AndrewwChon/PLL_MOSbius/bond_wire/README.md

## Bond Wire

The bond wires from the die to the package were modelled based on Jingde Hu's write-up for the QFN package.
This write-up takes inspiration from slides provided in Professor Peter Kinget's VLSI design course.
