AndrewwChon/PLL_MOSbius/bond_wire/MOSbius_Track1_Bonding_Diagram_Draft_04062026.pdf

### Chipathon 2025 MOSbius Track 1 Bonding Diagram Dra (NE/SW)

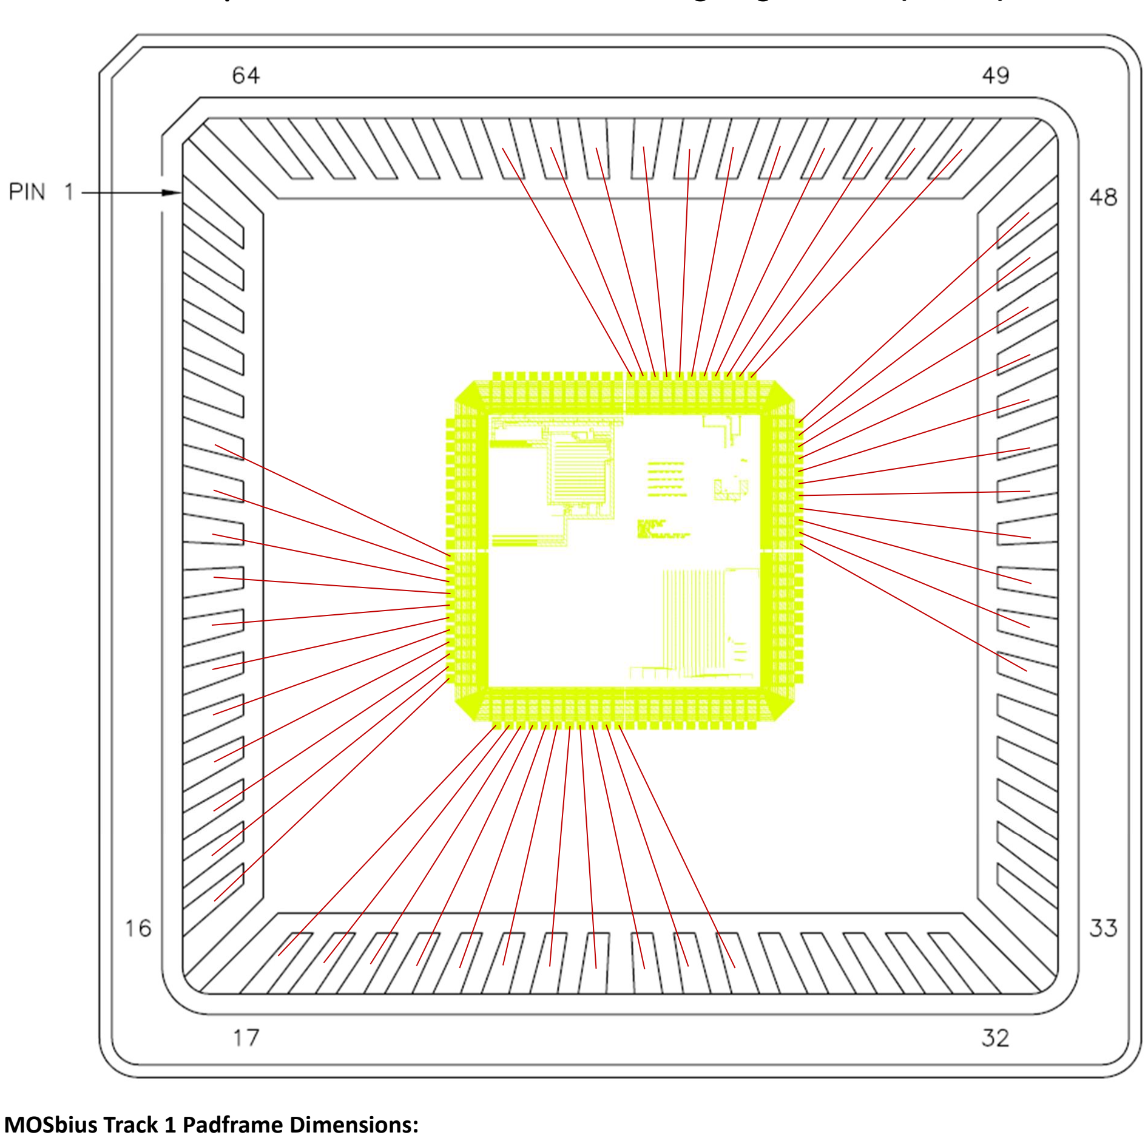
[picture p15: figure]
MOSbius Track 1 Padframe Dimensions:

o Overall Padframe Dimensions: 2.935 mm x 2.935 mm o Individual Pad Dimensions: 65.325 um x 68 um
o Pad/Passivaon Opening: 60 um x 60 um o Pad Pitch: 100 um
Package Dimensions (LQFP10X10-64-OP-01):
o Overall Package Dimensions: 10 mm x 10 mm
o Die Pad Dimensions: 6.858 mm x 6.858 mm Addional Informaon:
o Qty Packaged: 25
o Esmated Max Wire Length: 2 mm
o Lid Type: TBD. Please use Alumina Ceramic for budget esmates

### Chipathon 2025 MOSbius Track 1 Bonding Diagram Dra (NW/SE)

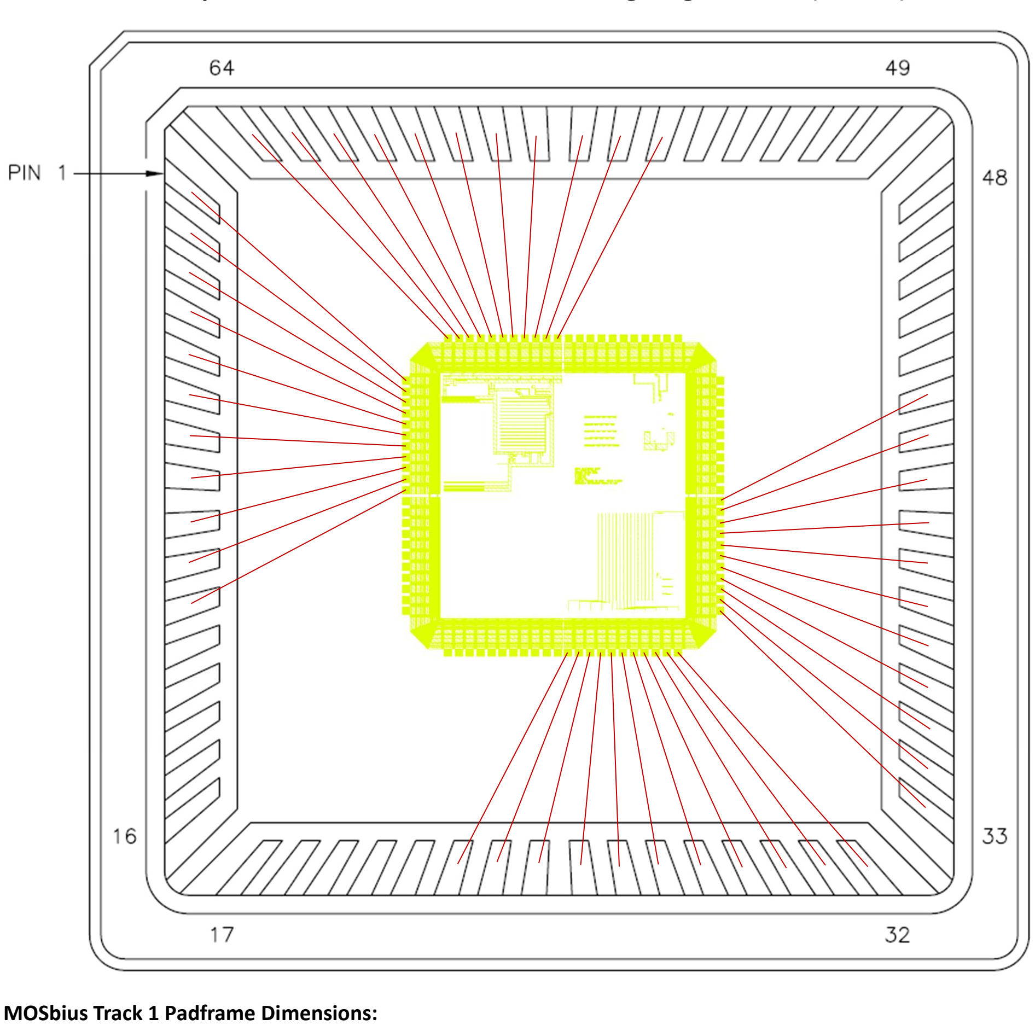
[picture p16: figure]
MOSbius Track 1 Padframe Dimensions:

o Overall Padframe Dimensions: 2.935 mm x 2.935 mm o Individual Pad Dimensions: 65.325 um x 68 um
o Pad/Passivaon Opening: 60 um x 60 um o Pad Pitch: 100 um
Package Dimensions (LQFP10X10-64-OP-01):
o Overall Package Dimensions: 10 mm x 10 mm
o Die Pad Dimensions: 6.858 mm x 6.858 mm Addional Informaon:
o Qty Packaged: 25
o Esmated Max Wire Length: 2 mm
o Lid Type: TBD. Please use Alumina Ceramic for budget esmates
