AndrewwChon/PLL_MOSbius/bond_wire/bond_wire_img.png

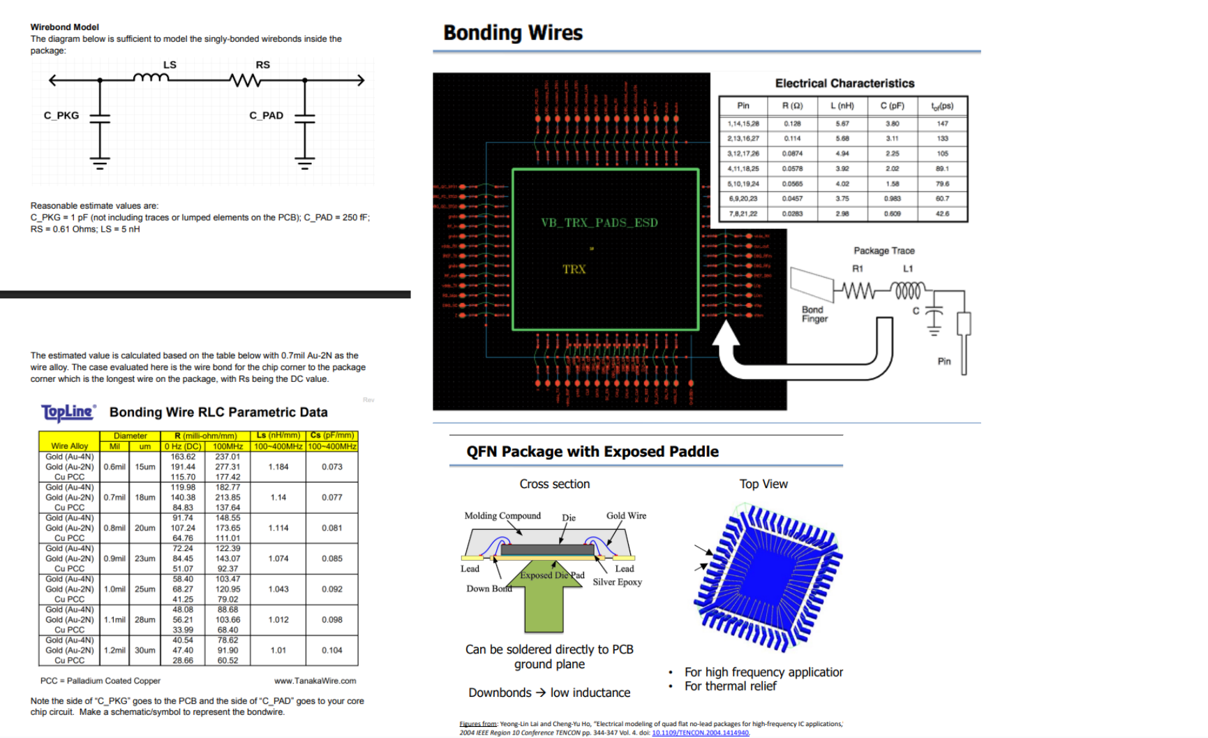
bond_wire/bond_wire_img.png
