AndrewwChon/PLL_MOSbius/docs/screenshots/add_collaborators.png

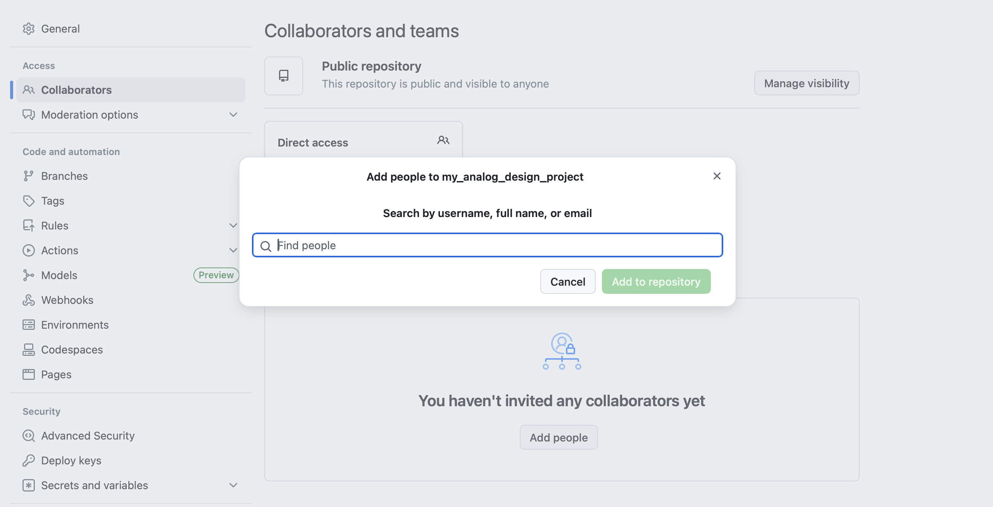
docs/screenshots/add_collaborators.png
