AndrewwChon/PLL_MOSbius/docs/screenshots/clone_your_repo.png

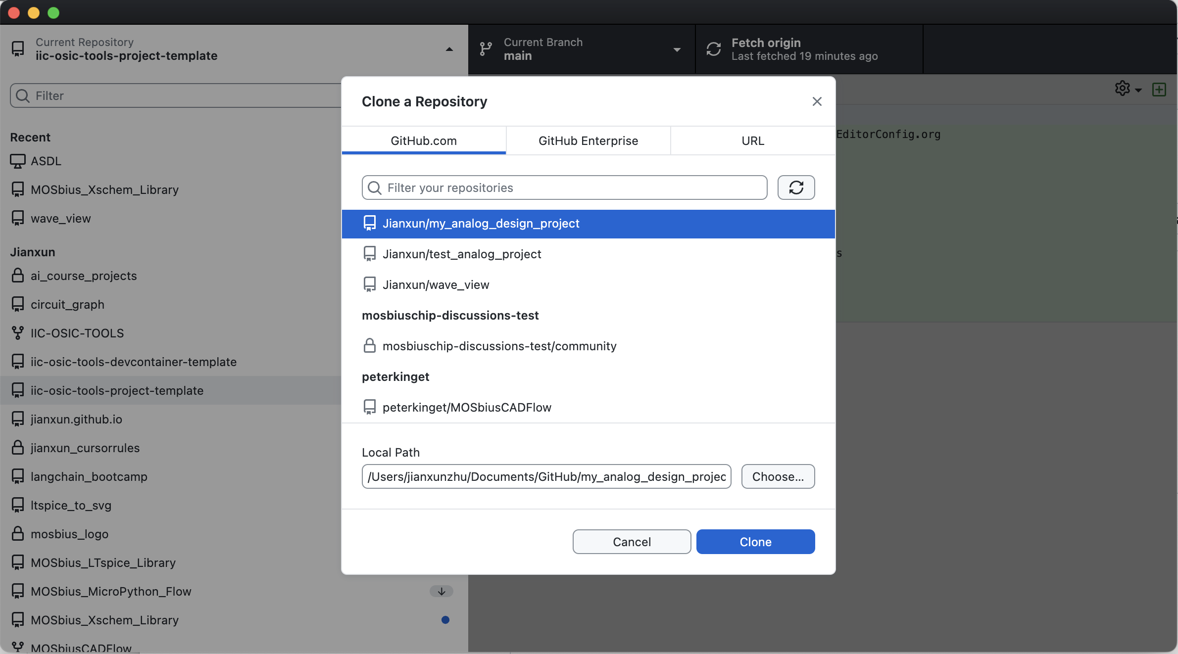
docs/screenshots/clone_your_repo.png
