AndrewwChon/PLL_MOSbius/docs/screenshots/create_new_repo.png

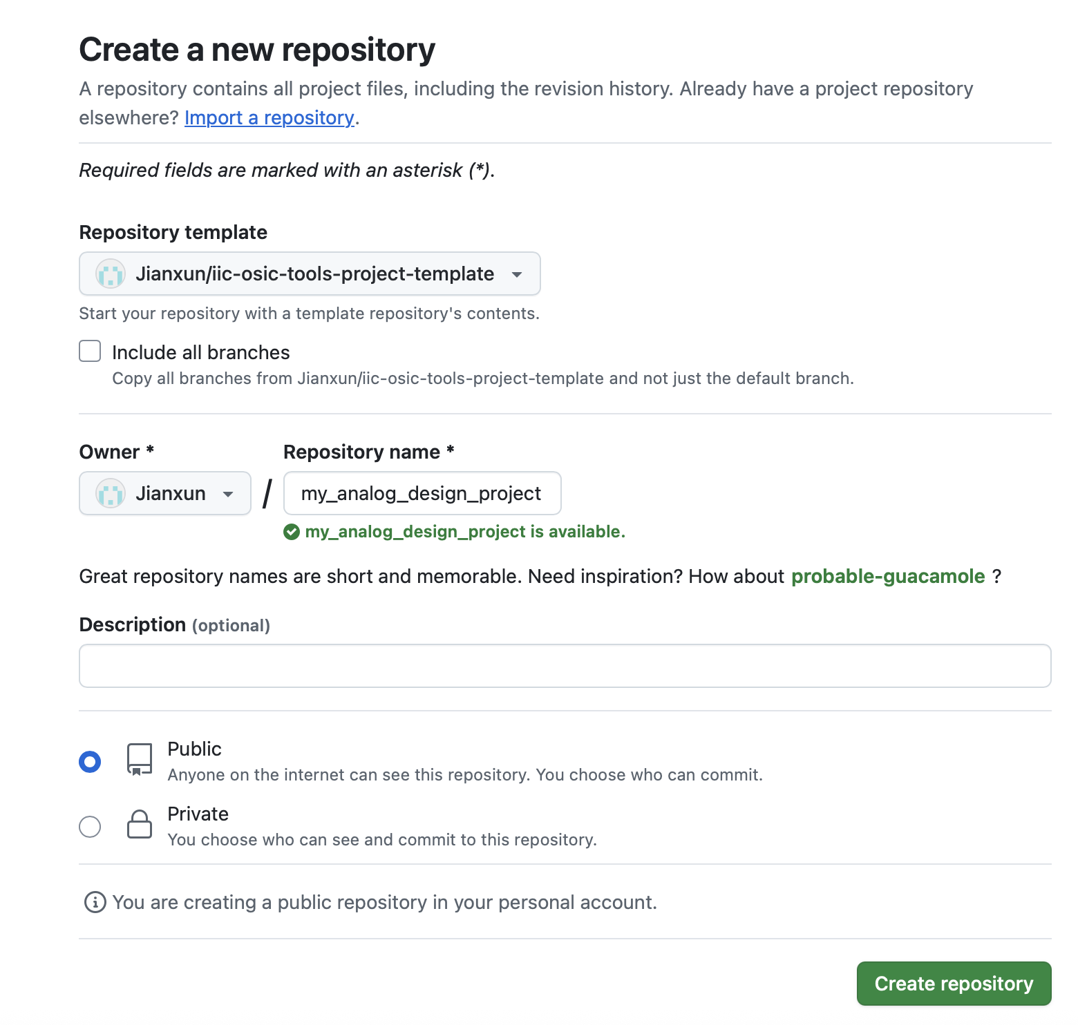
docs/screenshots/create_new_repo.png
