AndrewwChon/PLL_MOSbius/docs/screenshots/docker_pull.png

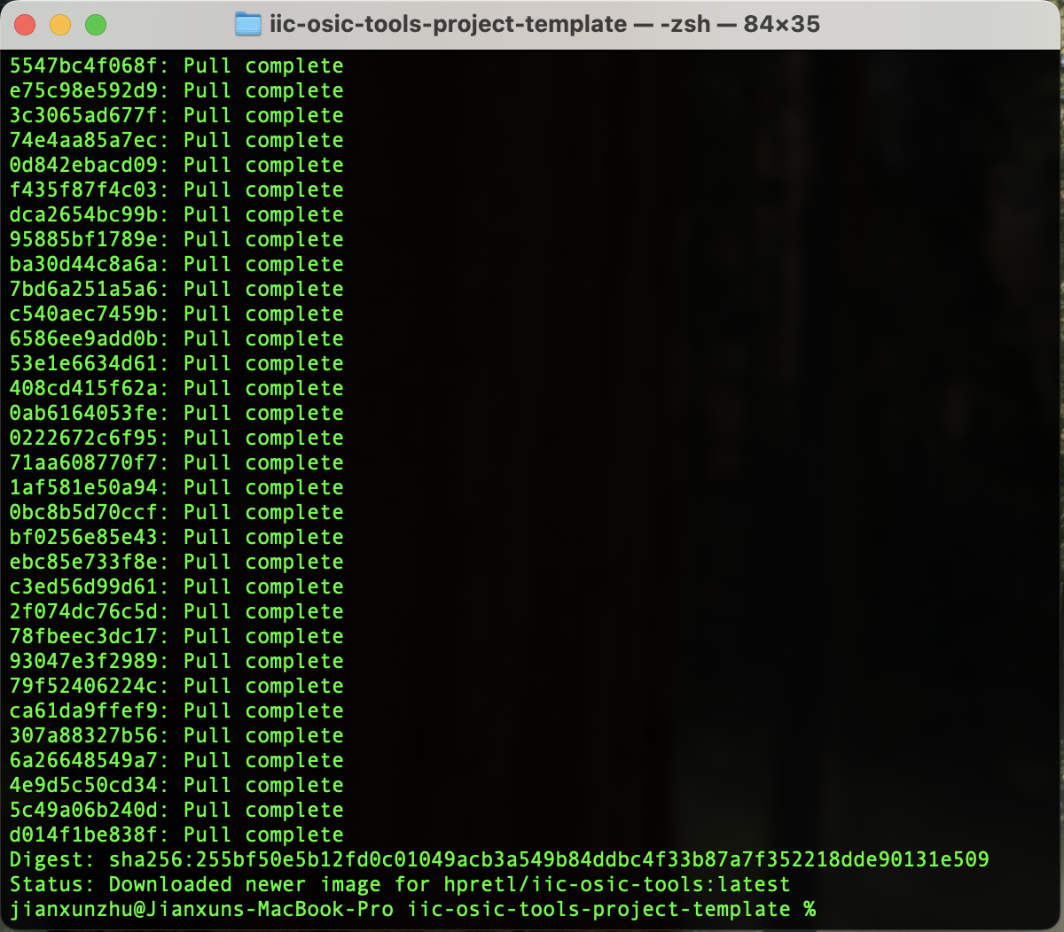
docs/screenshots/docker_pull.png
