AndrewwChon/PLL_MOSbius/docs/screenshots/open_a_terminal.png

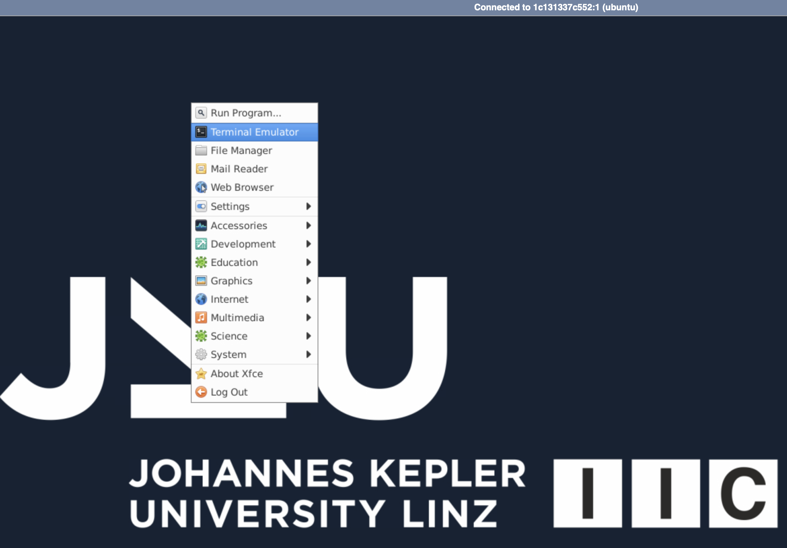
docs/screenshots/open_a_terminal.png
