AndrewwChon/PLL_MOSbius/docs/screenshots/start_klayout.png

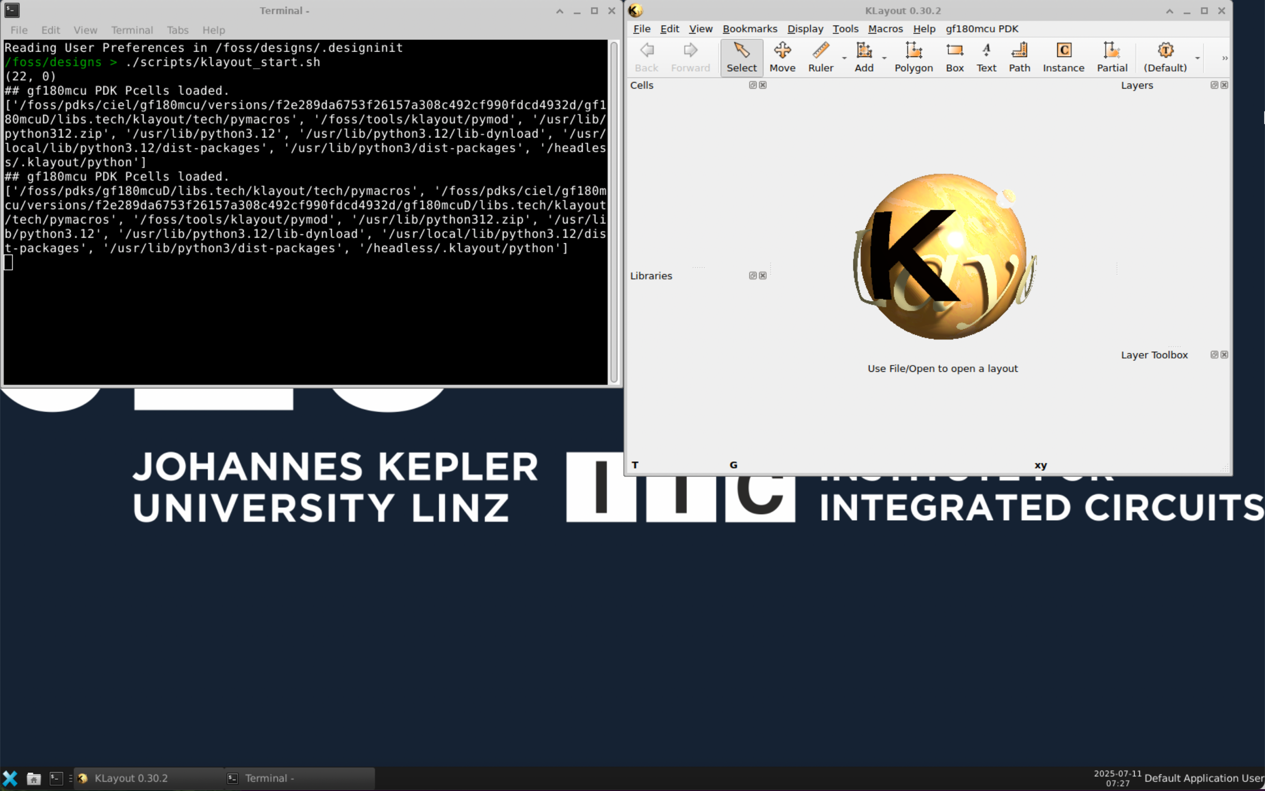
docs/screenshots/start_klayout.png
