AndrewwChon/PLL_MOSbius/docs/screenshots/start_xschem.png

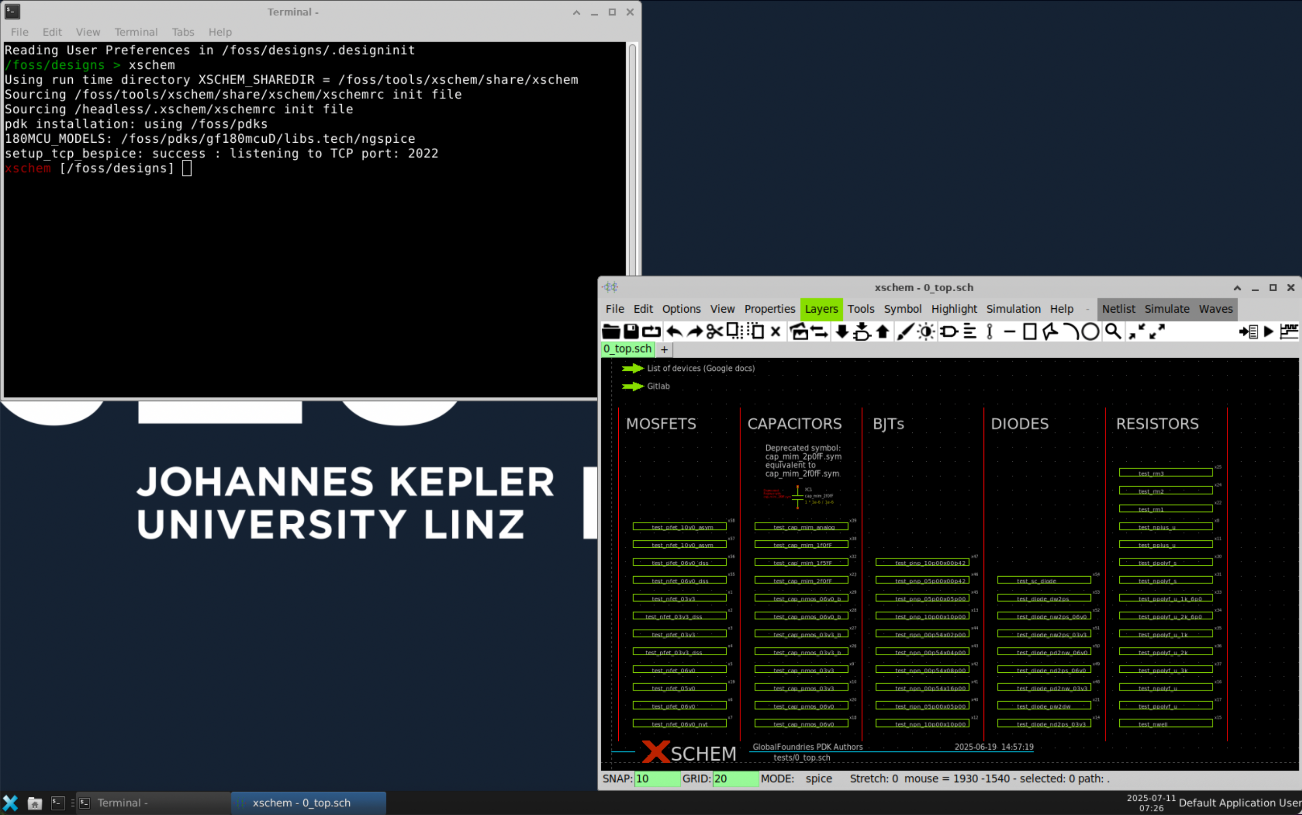
docs/screenshots/start_xschem.png
