AndrewwChon/PLL_MOSbius/docs/screenshots/using_github_template.png

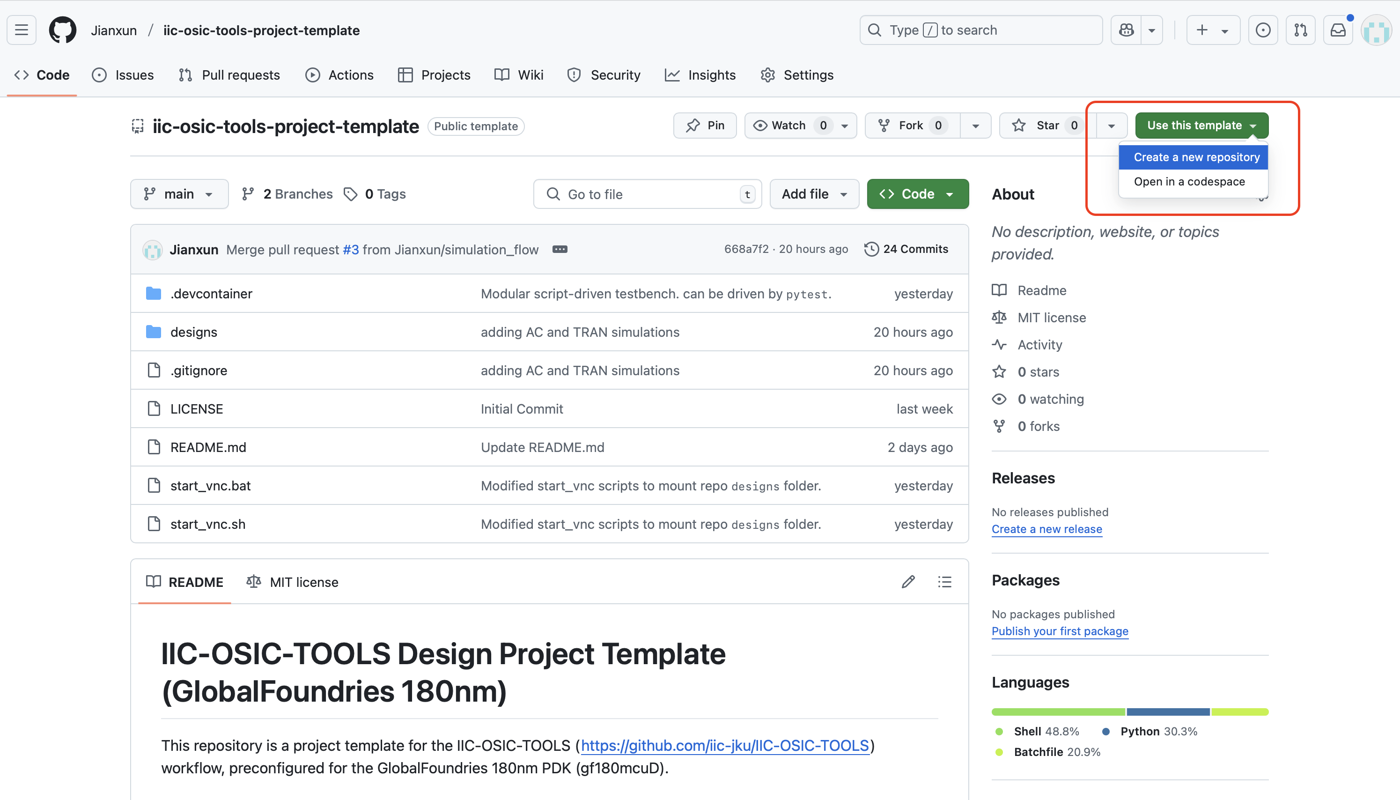
docs/screenshots/using_github_template.png
