AndrewwChon/PLL_MOSbius/docs/screenshots/setup_pdk.png

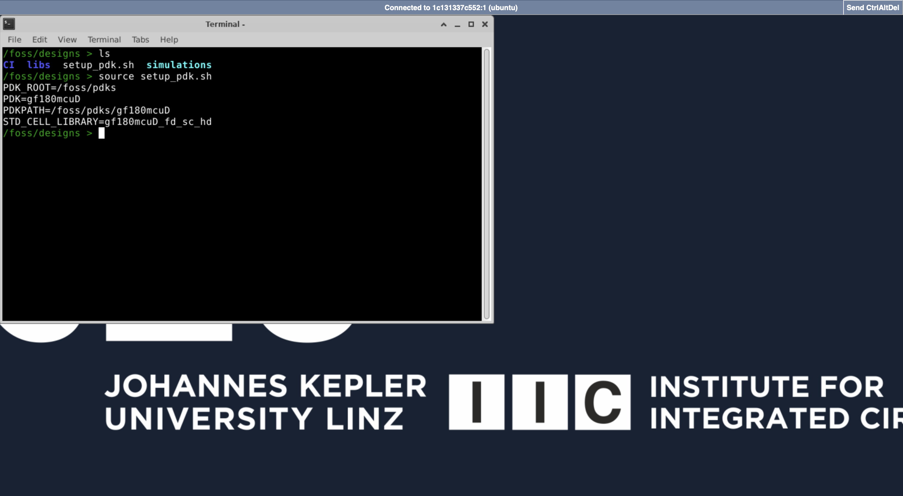
docs/screenshots/setup_pdk.png
