AndrewwChon/PLL_MOSbius/designs/switch_matrix_gf180mcu_9t5v0-main/tgate_PK/3p3V_tgate_N_P_separate_lv_vsweep_tb.pdf

# tgate_N_P_separate_lv_vsweep_tb.sch

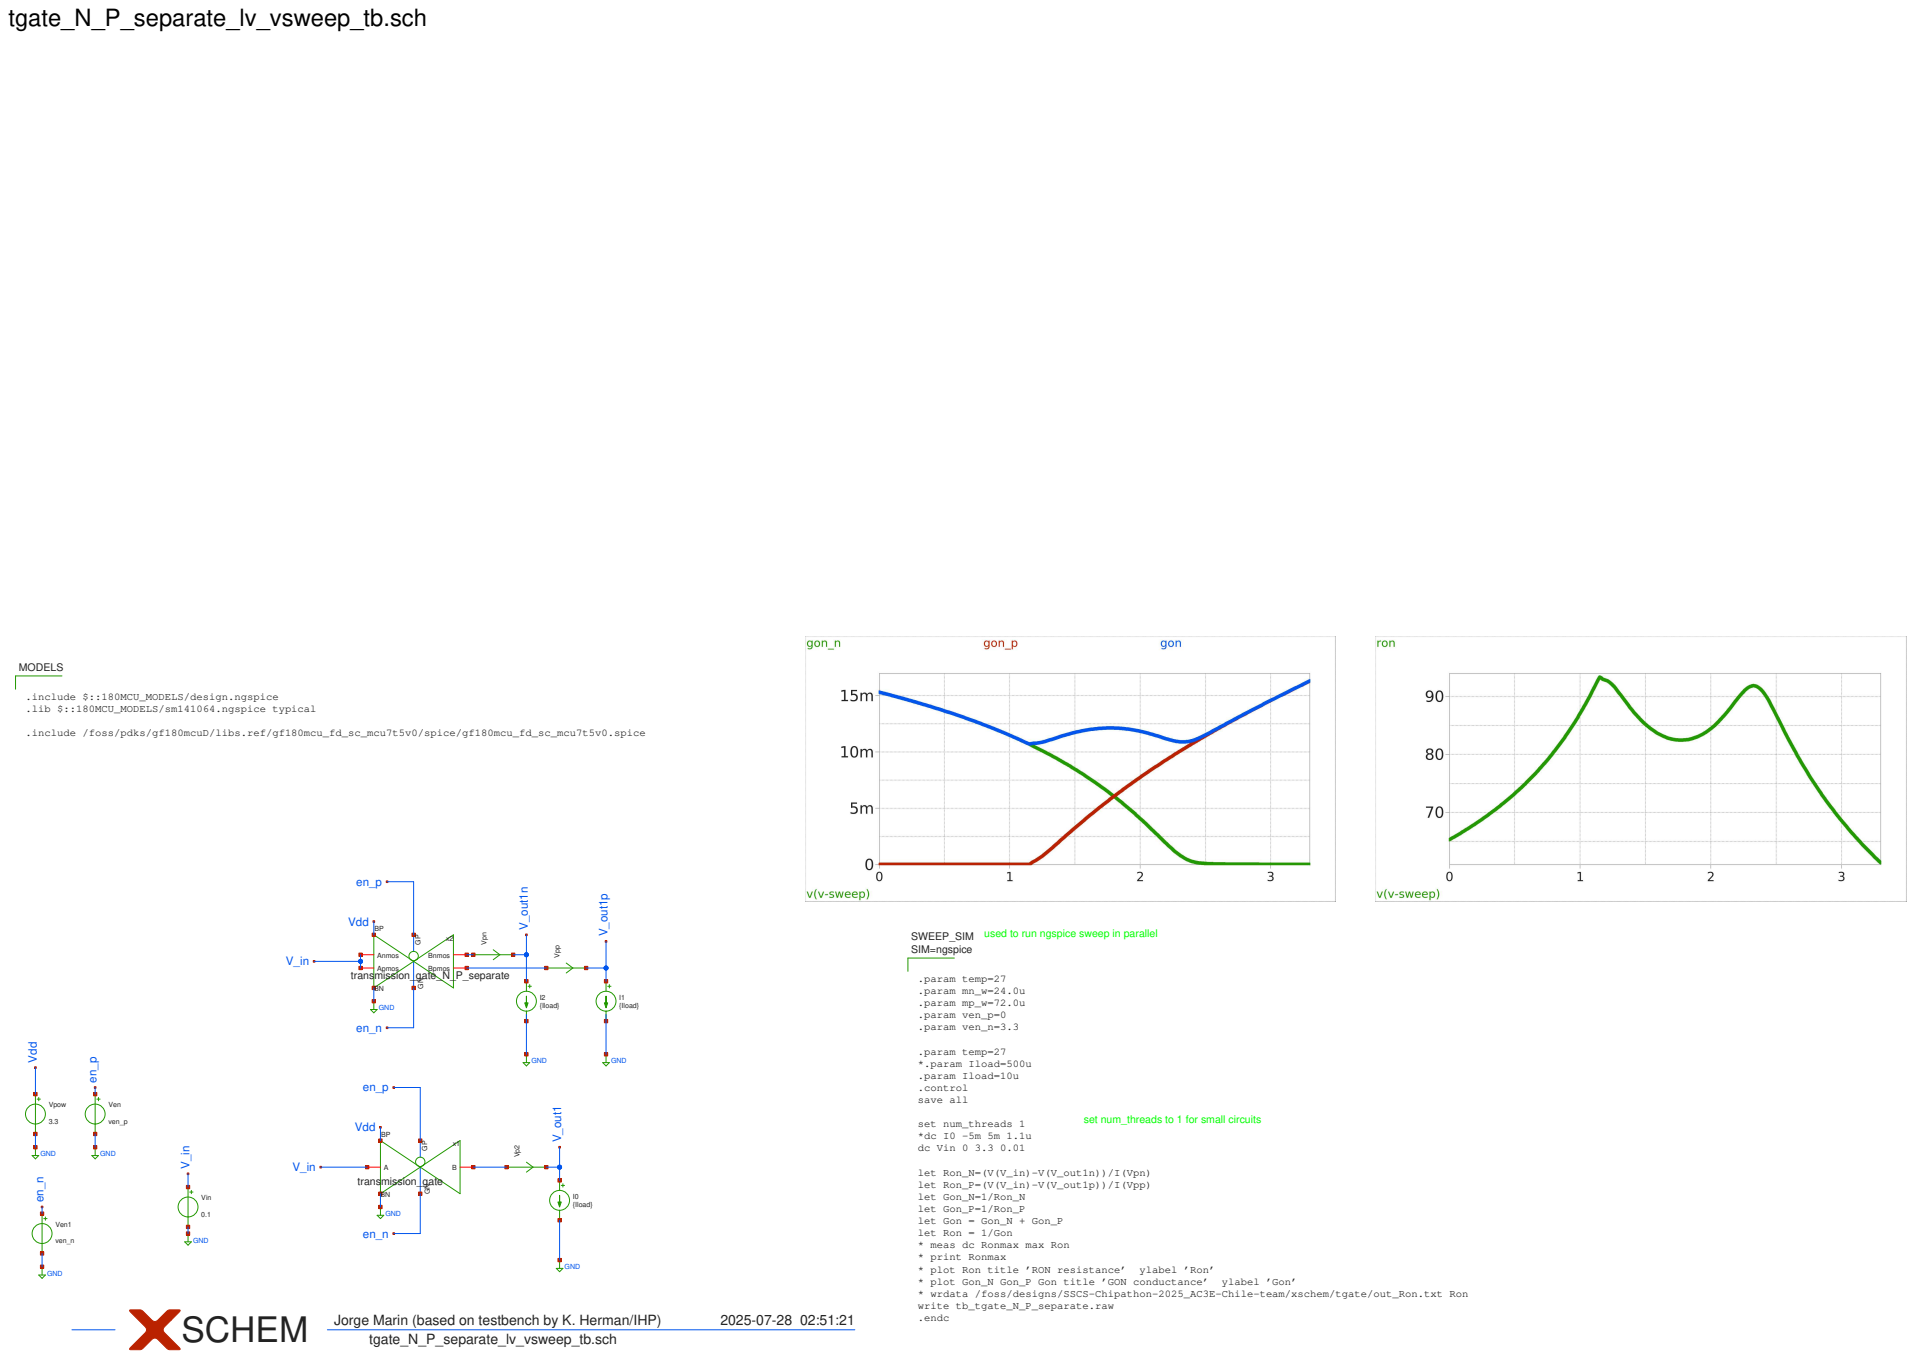
[picture p31: page 1]
tgate_N_P_separate_lv_vsweep_tb.sch; Jorge Marin (based on testbench by K. Herman/IHP); 2025-07-28 02:51:21 SCHEM; SWEEP_SIM; .param temp=27 .param mn_w=24.0u .param mp_w=72.0u .param ven_p=0 .param ven_n=3.3; .param temp=27 *.param Iload=500u .param Iload=10u .control save all; set num_threads 1 *dc I0 -5m 5m 1.1u dc Vin 0 3.3 0.01; * plot Ron title ’RON resistance’; ylabel ’Ron’; * plot Gon_N Gon_P Gon title ’GON conductance’; ylabel ’Gon’; SIM=ngspice; Vpow; GND; Vin; Ven; ven_p; V_out1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

.include $::180MCU_MODELS/design.ngspice
.lib $::180MCU_MODELS/sm141064.ngspice typical

.include /foss/pdks/gf180mcuD/libs.ref/gf180mcu_fd_sc_mcu7t5v0/spice/gf180mcu_fd_sc_mcu7t5v0.spice

used to run ngspice sweep in parallel

set num_threads to 1 for small circuits

let Ron_N=(V(V_in)-V(V_out1n))/I(Vpn)
let Ron_P=(V(V_in)-V(V_out1p))/I(Vpp)
let Gon_N=1/Ron_N
let Gon_P=1/Ron_P
let Gon = Gon_N + Gon_P
let Ron = 1/Gon
* meas dc Ronmax max Ron
* print Ronmax
* wrdata /foss/designs/SSCS-Chipathon-2025_AC3E-Chile-team/xschem/tgate/out_Ron.txt Ron
write tb_tgate_N_P_separate.raw
.endc
