AndrewwChon/PLL_MOSbius/(commit log)

2025-06-25 created 7-stage current starved ring VCO
2025-07-04 basic charge pump
2025-08-03 Top level create. Updated programmable pump
2025-08-05 XNOR Layout; Removed Standard Cell Fingers
2025-08-10 relayout cells - update
2025-08-12 0812update
    Built chargepump for vco (linear voltage to current). Met issues when running simulation for vco
2025-08-22 top level schematic and sim update
2025-08-29 0829update
    Relaxation VCO issue: large decap & effects of cap switches
    [DFF_2phase_1.sch, NO_ClkGen.sch, Schmitt.sch, Schmitt_tb.sch, ShiftReg_row_10.sch, ShiftReg_row_10_2.sch, Swmatrix.sch, data_swmatrix5_10.csv]
2025-08-31 VCO update:with&without TG
    two versions of VCO for verifying in PLL
    [DFF_2phase_1.sch]
2025-08-31 SRegister_10_update
    made schematic and symbol of 10 shift registers. can combine 3 of this to form 30 function
    [NO_ClkGen.sch]
2025-09-04 SRegisters_layout&NOLclk_update
    finished schematic and layout of SR unit cell.
    finished NOLclk generator schematic, NOL window being 6ns.
    [DFF_flatten.sch]
2025-09-04 XP updated for basic_cp in core_analog (removed UP inverter in layout, widened some metal wires)
2025-09-08 0908update
    finish layout of shift registers and bias circuit
2025-09-10 BIAS Circuit DRC/LVS Clean
2025-09-16 scan chain DRC/LVS clean
2025-09-26 Calibre DRC Fixes Update 1
    NW Spacing, MIMT10, Slotting, Antenna
2025-10-01 Final Filled DRC LVS Clean Submission MOSbius Frame 1
