AndrewwChon/PLL_MOSbius/(notices)

Notices in the files:
designs/switch_matrix_gf180mcu_9t5v0-main/designs/scripts/klayout_lib_manager/README.md:
License: GPLv3
